ISebSej/BSc_Thesis_HighPrecisionHumiditieController/README.md

# BSc_Thesis_HighPrecisionHumidityController
