ISebSej/BSc_Thesis_HighPrecisionHumiditieController/EDA/AirSensorModule/Part Studio 2.step

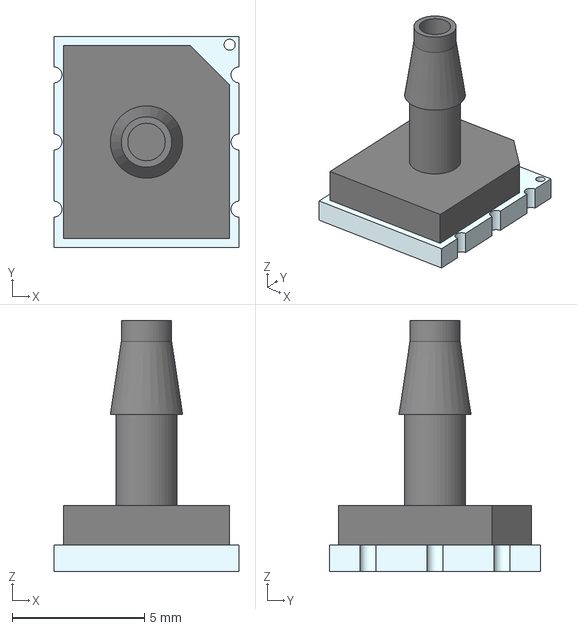
[picture p8: CAD file, 2020-11-11]
EDA/AirSensorModule/Part Studio 2.step
7.00 x 8.00 x 9.50 mm
