ISebSej/BSc_Thesis_HighPrecisionHumiditieController/EDA/PowerModule/HDSP-433G.step

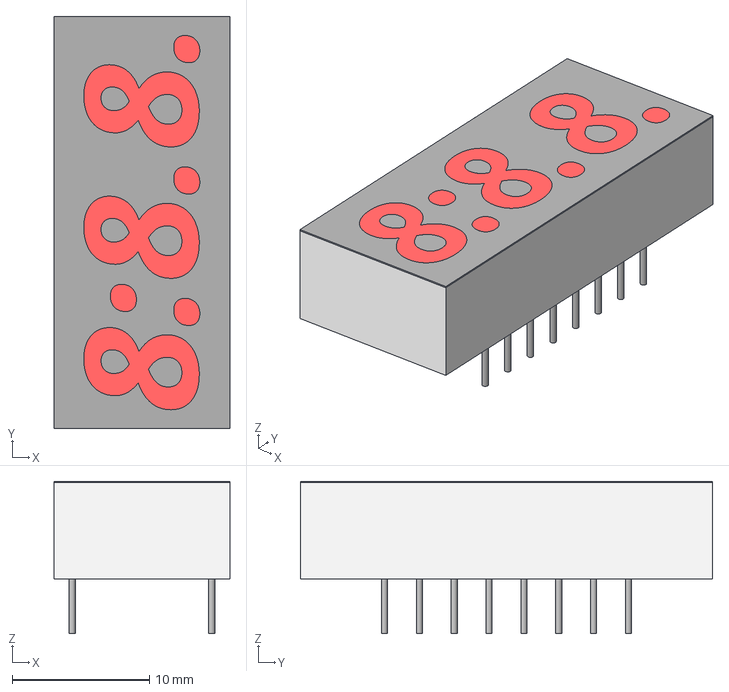
[picture p9: CAD file, 2020-11-11]
EDA/PowerModule/HDSP-433G.step
12.8 x 30.0 x 11.1 mm
