ISebSej/BSc_Thesis_HighPrecisionHumiditieController/EDA/AirSensorModule/AirSensorModule.kicad_pcb

## KiCad design EDA/AirSensorModule/AirSensorModule.kicad_pcb (2020-11-11)

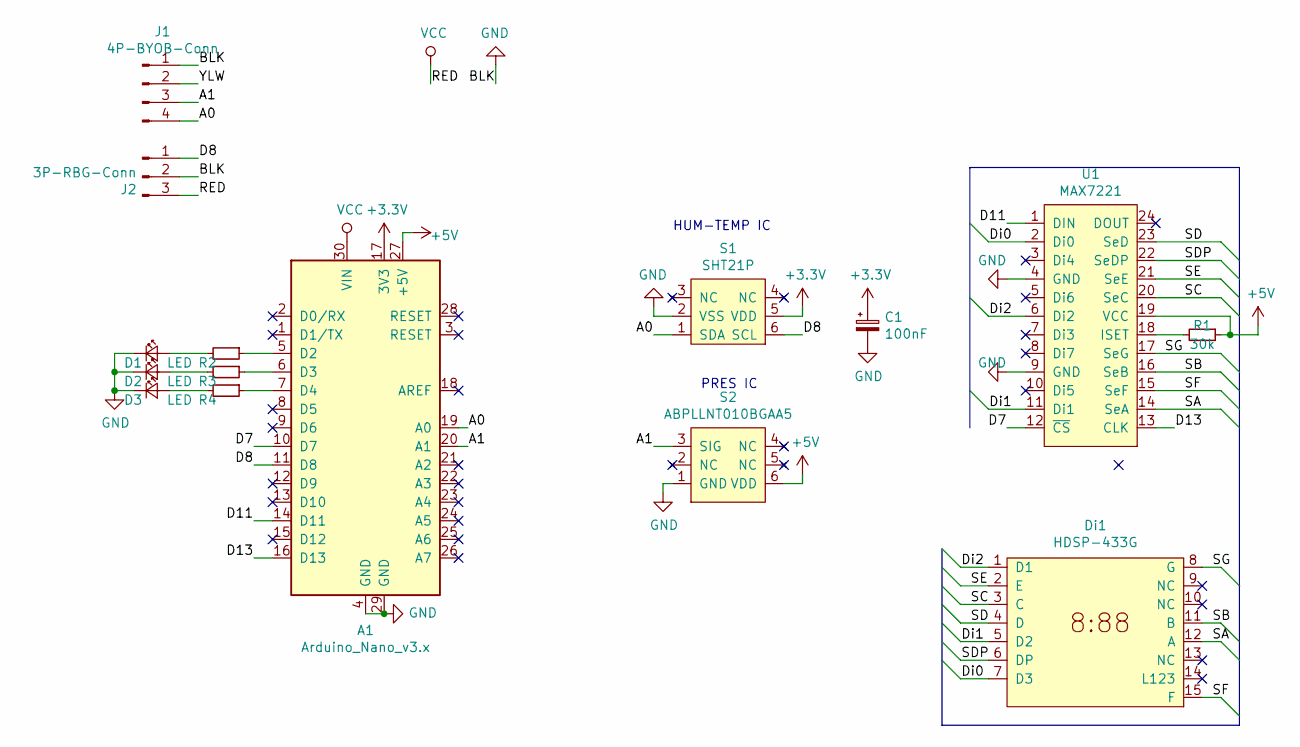
[picture p10: schematic AirSensorModule.sch]

Parts:
A1: Arduino_Nano_v3.x; Arduino_Nano
C1: 100nF; CP_Radial_Tantal_D7.0mm_P2.50mm
D1, D2, D3: LED; LED_0603_1608Metric
Di1: HDSP-433G
J1: 4P-BYOB-Conn; FanPinHeader_1x04_P2.54mm_Vertical
J2: 3P-RBG-Conn; FanPinHeader_1x03_P2.54mm_Vertical
R1: 30k; R_Axial_DIN0204_L3.6mm_D1.6mm_P5.08mm_Horizontal
R2, R3, R4: R_Axial_DIN0204_L3.6mm_D1.6mm_P5.08mm_Horizontal
S1: SHT21P; DFN-6-1EP_3x3mm_P1mm_EP1.5x2.4mm
S2: ABPLLNT010BGAA5; ABPxx - LeadlessSMT
U1: MAX7221; DIP-24_W7.62mm_LongPads

Connections:
+3V3: A1.17 (3V3), C1.1, S1.5 (VDD)
+5V: A1.27 (+5V), R1.1, S2.6 (VDD), U1.19 (VCC)
/A0: A1.19 (A0), J1.4, S1.1 (SDA)
/A1: A1.20 (A1), J1.3, S2.3 (SIG)
/D7: A1.10 (D7), U1.12 (~CS)
/D8: A1.11 (D8), J2.1, S1.6 (SCL)
/D11: A1.14 (D11), U1.1 (DIN)
/D13: A1.16 (D13), U1.13 (CLK)
/Di0: Di1.7 (D3), U1.2 (Di0)
/Di1: Di1.5 (D2), U1.11 (Di1)
/Di2: Di1.1 (D1), U1.6 (Di2)
/SA: Di1.12 (A), U1.14 (SeA)
/SB: Di1.11 (B), U1.16 (SeB)
/SC: Di1.3 (C), U1.20 (SeC)
/SD: Di1.4 (D), U1.23 (SeD)
/SDP: Di1.6 (DP), U1.22 (SeDP)
/SE: Di1.2 (E), U1.21 (SeE)
/SF: Di1.15 (F), U1.15 (SeF)
/SG: Di1.8 (G), U1.17 (SeG)
/YLW: J1.2
GND: A1.4 (GND), A1.29 (GND), C1.2, D1.1 (K), D2.1 (K), D3.1 (K), J1.1, J2.2, S1.2 (VSS), S1.7, S2.1 (GND), U1.4 (GND), U1.9 (GND)
unnamed: A1.5 (D2), R2.1
unnamed: A1.6 (D3), R3.1
unnamed: A1.7 (D4), R4.1
unnamed: D1.2 (A), R2.2
unnamed: D2.2 (A), R3.2
unnamed: D3.2 (A), R4.2
unnamed: R1.2, U1.18 (ISET)
VCC: A1.30 (VIN), J2.3

Notes on the sheet:
HUM-TEMP IC
PRES IC

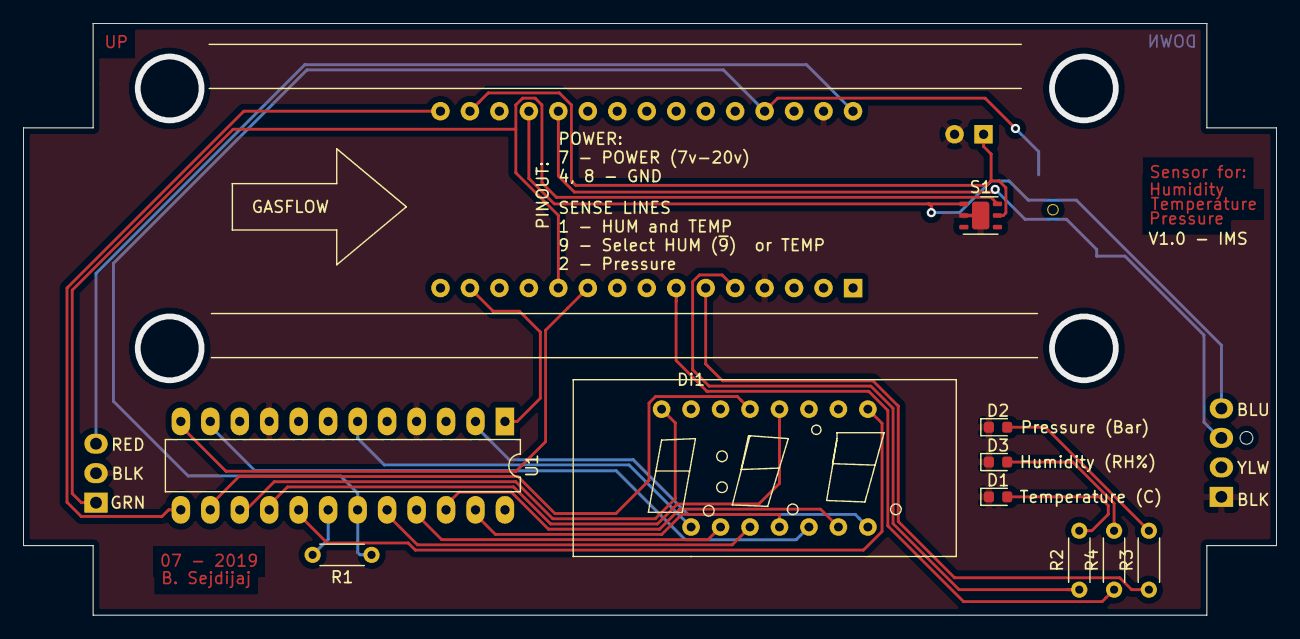
[picture p11: board AirSensorModule.kicad_pcb from above]

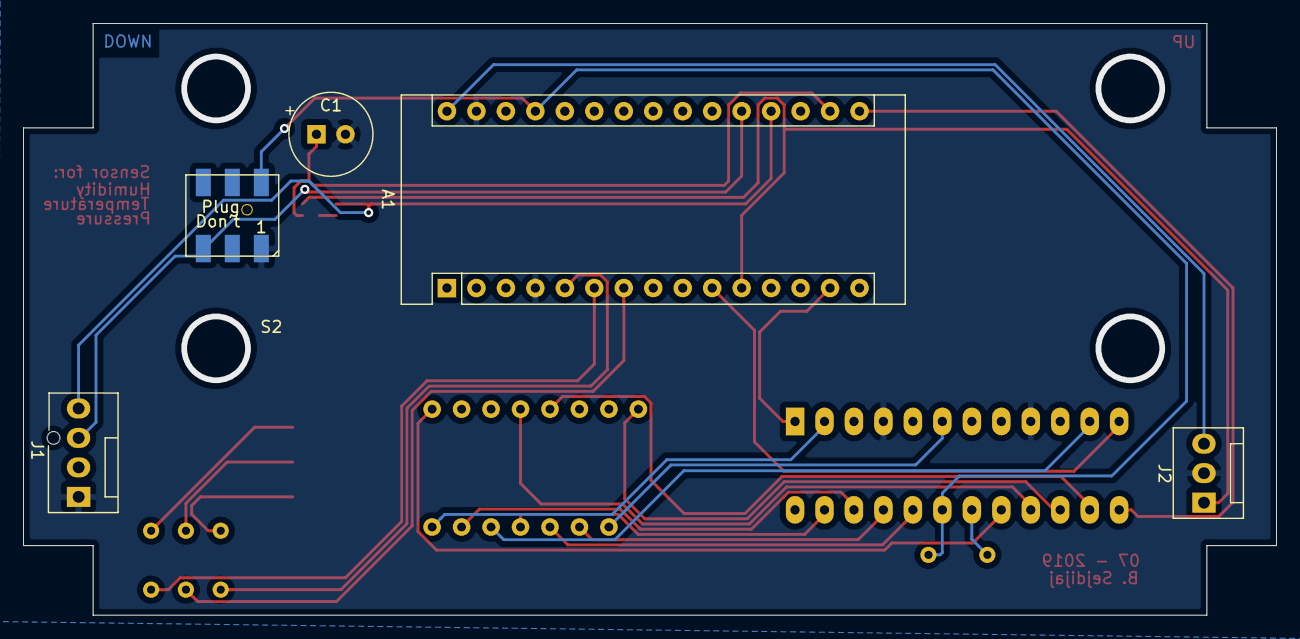
[picture p12: board AirSensorModule.kicad_pcb from below]

Board: 2 copper layers, 108.0 x 51.0 mm, 15 parts (5 on the bottom side), 28 nets.
